S-Ng/Automated_Pill_Dispenser/(commit log)

2019-02-03 Biopolar stepper motor (Trial 1)
    Taken from https://learn.adafruit.com/adafruit-tb6612-h-bridge-dc-stepper-motor-driver-breakout/using-stepper-motors
    Their setup seems the same as mine, but the stepper didn't turn.
    It's possible that the driver board needs to be soldered first.
    [StepperMotor1.ino]
2019-02-23 Code for controlling arduino uno
2019-02-23 Added Compartment and Elevator Stepper Codes
    Might need to edit compartment code to move correct number of steps (it moves fastest direction, but maybe not the right number of steps)
    [Uno_Control.ino]
2019-03-03 Uno code with corrected two-stepper interaction
    [Uno_control.2.ino]
